AlexGyver/IP_car/README.md

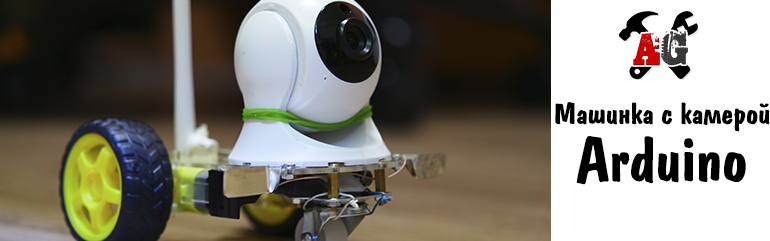
[picture p1: proj_img.jpg]
PROJECT_PHOTO

# Wi-Fi машинка на Arduino своими руками
* [Описание проекта](#chapter-0)
* [Папки проекта](#chapter-1)
* [Схемы подключения](#chapter-2)
* [Материалы и компоненты](#chapter-3)
* [Как скачать и прошить](#chapter-4)
* [FAQ](#chapter-5)
* [Полезная информация](#chapter-6)
AlexGyver YouTube (https://www.youtube.com/channel/UCgtAOyEQdAyjvm9ATCi_Aig?sub_confirmation=1)

## Описание проекта
Машинка с камерой и управлением через интернет на Arduino. Основана на китайской IP камере =)
Страница проекта на сайте: https://alexgyver.ru/IP_car/  
   
#### Особенности:
- Фишки, унаследованные от камеры:
	- Картинка 1280x720
	- Ночной режим (с ИК подсветкой)
	- Запись видео и съёмка фото
	- Режим рации (двухсторонняя аудиосвязь)
- Управление из родного приложения
- Настройки скорости и продолжительности движения

## Папки
**ВНИМАНИЕ! Если это твой первый опыт работы с Arduino, читай [инструкцию](#chapter-4)**
- **libraries** - библиотеки проекта. Заменить имеющиеся версии
- **firmware** - прошивки для Arduino
- **schemes** - схемы подключения компонентов

## Схемы
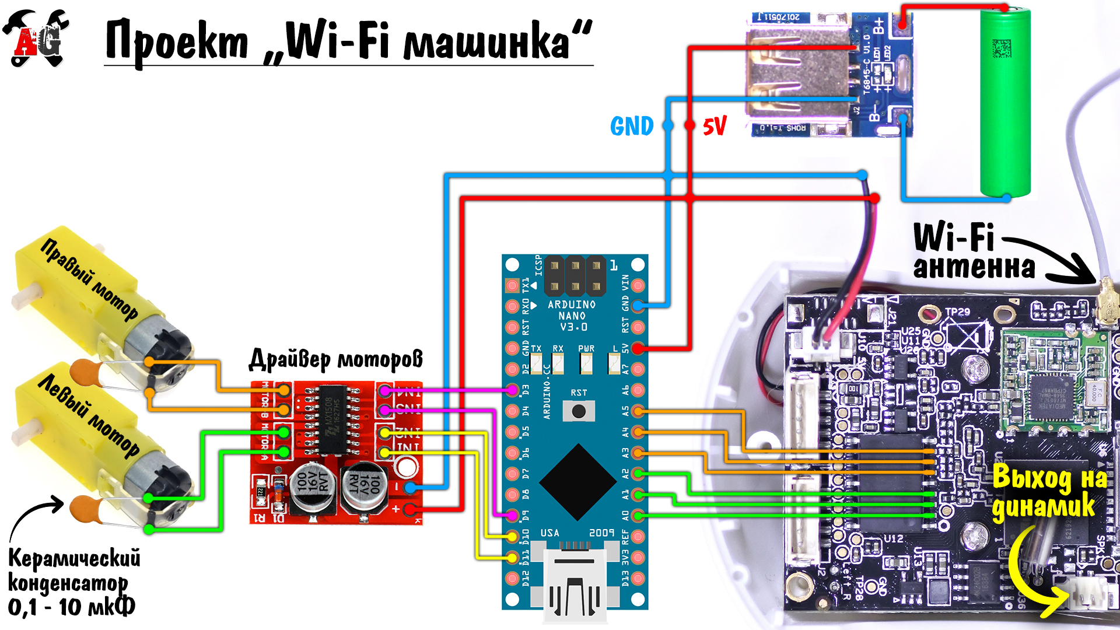
[picture p2: schemes/scheme.jpg]
SCHEME


## Материалы и компоненты
### Ссылки оставлены на магазины, с которых я закупаюсь уже не один год
- Arduino NANO https://ali.ski/kILdB9  https://ali.ski/H0iTcj
- SANNCE камера https://ali.ski/ZqMduo
- Платформа с моторами и колёсами https://ali.ski/jvZIKw
- Драйвер моторов https://ali.ski/mRAs_f
Дополнительно:  
- Отсек под 18650 https://ali.ski/YwO9Rv
- Акум 18650 https://ali.ski/fpsSQ  https://ali.ski/4nbwDd
- Модуль 5V с зарядкой https://ali.ski/2RR7uD

## Вам скорее всего пригодится
* [Всё для пайки (паяльники и примочки)](http://alexgyver.ru/all-for-soldering/)
* [Недорогие инструменты](http://alexgyver.ru/my_instruments/)
* [Все существующие модули и сенсоры Arduino](http://alexgyver.ru/arduino_shop/)
* [Электронные компоненты](http://alexgyver.ru/electronics/)
* [Аккумуляторы и зарядные модули](http://alexgyver.ru/18650/)

## Как скачать и прошить
* [Первые шаги с Arduino](http://alexgyver.ru/arduino-first/) - ультра подробная статья по началу работы с Ардуино, ознакомиться первым делом!
* Скачать архив с проектом
> На главной странице проекта (где ты читаешь этот текст) вверху справа зелёная кнопка **Clone or download**, вот её жми, там будет **Download ZIP**
* Установить библиотеки в  
`C:\Program Files (x86)\Arduino\libraries\` (Windows x64)  
`C:\Program Files\Arduino\libraries\` (Windows x86)
* **Подключить внешнее питание 5 Вольт**
* Подключить Ардуино к компьютеру
* Запустить файл прошивки (который имеет расширение .ino)
* Настроить IDE (COM порт, модель Arduino, как в статье выше)
* Настроить что нужно по проекту
* Нажать загрузить
* Пользоваться  

## Настройки в коде
    FRW_SPEED 120     // скорость движения вперёд (0-255)
    BKW_SPEED 80      // скорость движения назад (0-255)
    TURN_SPEED 95     // скорость поворота (0-255)
    MOVE_TIME 3       // время, которое машинка едет после команды (секунды)
    TURN_TIME 0.4     // время, которое машинка крутится после команды (секунды)

    TIMEOUT 700       // таймаут опроса выхода с драйвера (длительность отправки сигнала на моторы КАМЕРЫ)
    START_DELAY 100   // задержка включения, секунды (ждём калибровку камеры)

    // поворот НАЛЕВО и движение НАЗАД ограничены
    INVERT_X 1        // инверт горизонтальной оси
    INVERT_Y 1        // инверт вертикальной оси

## FAQ
### Основные вопросы
В: Как скачать с этого грёбаного сайта?  
О: На главной странице проекта (где ты читаешь этот текст) вверху справа зелёная кнопка **Clone or download**, вот её жми, там будет **Download ZIP**

В: Скачался какой то файл .zip, куда его теперь?  
О: Это архив. Можно открыть стандартными средствами Windows, но думаю у всех на компьютере установлен WinRAR, архив нужно правой кнопкой и извлечь.

В: Я совсем новичок! Что мне делать с Ардуиной, где взять все программы?  
О: Читай и смотри видос http://alexgyver.ru/arduino-first/

В: Вылетает ошибка загрузки / компиляции!
О: Читай тут: https://alexgyver.ru/arduino-first/#step-5

В: Сколько стоит?  
О: Ничего не продаю.

### Вопросы по этому проекту

## Полезная информация
* [Мой сайт](http://alexgyver.ru/)
* [Основной YouTube канал](https://www.youtube.com/channel/UCgtAOyEQdAyjvm9ATCi_Aig?sub_confirmation=1)
* [YouTube канал про Arduino](https://www.youtube.com/channel/UC4axiS76D784-ofoTdo5zOA?sub_confirmation=1)
* [Мои видеоуроки по пайке](https://www.youtube.com/playlist?list=PLOT_HeyBraBuMIwfSYu7kCKXxQGsUKcqR)
* [Мои видеоуроки по Arduino](http://alexgyver.ru/arduino_lessons/)
