AlexGyver/IP_car/(threads)

Thread 1 (2023-02-07):

Самодиагностика и позиционирование камеры

TherealHypocrisy, 2023-02-07:
Привет, а как был решён вопрос с самодиагностикой камеры? У меня немного другая  камера, при включении она проводит самодиагностику и позиционирование, а потом выключается, я так понимаю из за ошибки позиционирования.

shinji2009, 2023-04-22:
может там конечники какие-то есть у камеры

Thread 2 (2023-04-22):

новые камеры ни в какую сторону не поворачиваются бесконечно

shinji2009, 2023-04-22:
привет. новые камеры производителя из видео ни в какую сторону не поворачиваются бесконечно, видимо производитель не хочет чтобы их камеры использовали как машинки. может исправите код под это?
